magnifico40/ROS_robot/pulpit.png

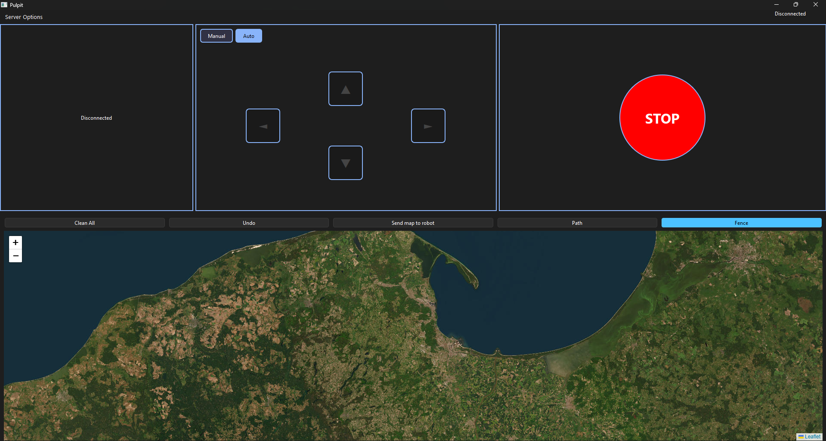
pulpit.png
