magnifico40/ROS_robot/foc controller/pcb/BOM_FOC_controller_PCB1_2026-02-05.xlsx

No. | Quantity | Comment | Designator | Footprint | Value | Manufacturer Part | Manufacturer | Supplier Part | Supplier
1 | 3 | 330uF | C1,C16,C17 | CAP-TH_BD13.0-P5.00-D1.2-FD | 330uF | 63V330uF CD288 | HRK(鸿瑞凯电子) | C2960417 | LCSC
2 | 3 | 4.7nF | C22,C23,C24 | C0805 | 4.7nF | CC0805KRX7R9BB472 | YAGEO(国巨) | C107153 | LCSC
3 | 6 | 100nF | C25,C26,C27,C31,C32,C33 | C0805 | 100nF | CC0805KRX7R9BB104 | YAGEO(国巨) | C49678 | LCSC
4 | 2 | 1uF | C34,C35 | C0805 | 1uF | CL21B105KBFNNNE | SAMSUNG(三星) | C28323 | LCSC
5 | 3 | 4.7uF | C36,C37,C38 | C1206 | 4.7uF | CL31B475KBHNNNE | SAMSUNG(三星) | C51205 | LCSC
6 | 1 | XT60U-M | CN1 | CONN-TH_XT60U-M |  | XT60U-M | AMASS(艾迈斯) | C129184 | LCSC
7 | 1 | XY-B5B-XH | CN2 | CONN-TH_5P-P2.50_XY-B5B-XH |  | XY-B5B-XH | XYECONN(辛译) | C51940193 | LCSC
8 | 3 | UF4007 | D1,D2,D3 | DO-41_BD2.4-L4.7-P8.70-D0.9-RD |  | UF4007 | MDD(辰达半导体) | C960666 | LCSC
9 | 1 | ESP32-S3-Zero | Filippo | esp32-s3-zero
10 | 1 | LM2596 | Filippo1 | stepDownLM2596
11 | 2 | 2.54-1*4P母 | H2,H3 | HDR-TH_4P-P2.54-V-F |  | 2.54-1*4P母 | BOOMELE(博穆精密) | C2718488 | LCSC
12 | 1 | PM2.54-1X8PM-H85 | P1 | HDR-TH_8P-P2.54-V-F |  | PM2.54-1X8PM-H85 | JXTCONN(聚兴泰) | C42431840 | LCSC
13 | 1 | WJ500V-5.08-03P-14-00A | P2 | CONN-TH_3P-P5.00_WJ500V-5.08-3P |  | WJ500V-5.08-03P-14-00A | KANGNEX(康奈克斯电气) | C72334 | LCSC
14 | 6 | STP110N8F6 | Q1,Q2,Q3,Q4,Q5,Q6 | TO-220-3_L10.0-W4.5-P2.54-L |  | STP110N8F6 | ST(意法半导体) | C81146 | LCSC
15 | 3 | 2mΩ | R1,R11,R18 | R2512 | 2mΩ | JER2512F3R002 | JIERR(捷而瑞) | C46634447 | LCSC
16 | 6 | 20Ω | R2,R3,R12,R13,R19,R20 | RES-TH_BD3.5-L9.0-P13.00-D0.5 | 20Ω | MO1/2W-20Ω±5%-XT52 | VO(翔胜) | C601756 | LCSC
17 | 12 | 10kΩ | R4,R5,R6,R7,R14,R15,R16,R17,R21,R22,R23,R24 | RES-TH_BD2.7-L6.2-P10.20-D0.4 | 10kΩ | MF1/4W-10K±1%-ST52 | VO(翔胜) | C2903232 | LCSC
18 | 3 | 1kΩ | R8,R25,R26 | RES-TH_BD2.7-L6.2-P10.20-D0.4 | 1kΩ | MF1/4W-1K±1%-ST52 | VO(翔胜) | C2903245 | LCSC
19 | 1 | 47kΩ | R9 | RES-TH_BD2.2-L6.5-P10.50-D0.6 | 47kΩ | MF1/4W-47KΩ±1% T | CCO(千志电子) | C119362 | LCSC
20 | 1 | 3.3kΩ | R10 | RES-TH_BD2.3-L6.5-P10.50-D0.5 | 3.3kΩ | MF1/4W-3.3KΩ±1% T | CCO(千志电子) | C119335 | LCSC
21 | 3 | EG2104S | U1,U3,U5 | SOIC-8_L5.0-W4.0-P1.27-LS6.0-BL |  | EG2104S | EG(屹晶微) | C480652 | LCSC
22 | 3 | INA240A1PWR | U2,U4,U6 | TSSOP-8_L4.4-W3.0-P0.65-LS6.4-BL |  | INA240A1PWR | TI(德州仪器) | C93965 | LCSC
23 | 1 | L7805 | U7 | TO-220-3_L10.0-W4.5-P2.54-L |  | L7805 | OSEN(欧芯) | C22378639 | LCSC
