magnifico40/ROS_robot/foc controller/pcb/SCH_FOC_controller_2026-04-19.pdf

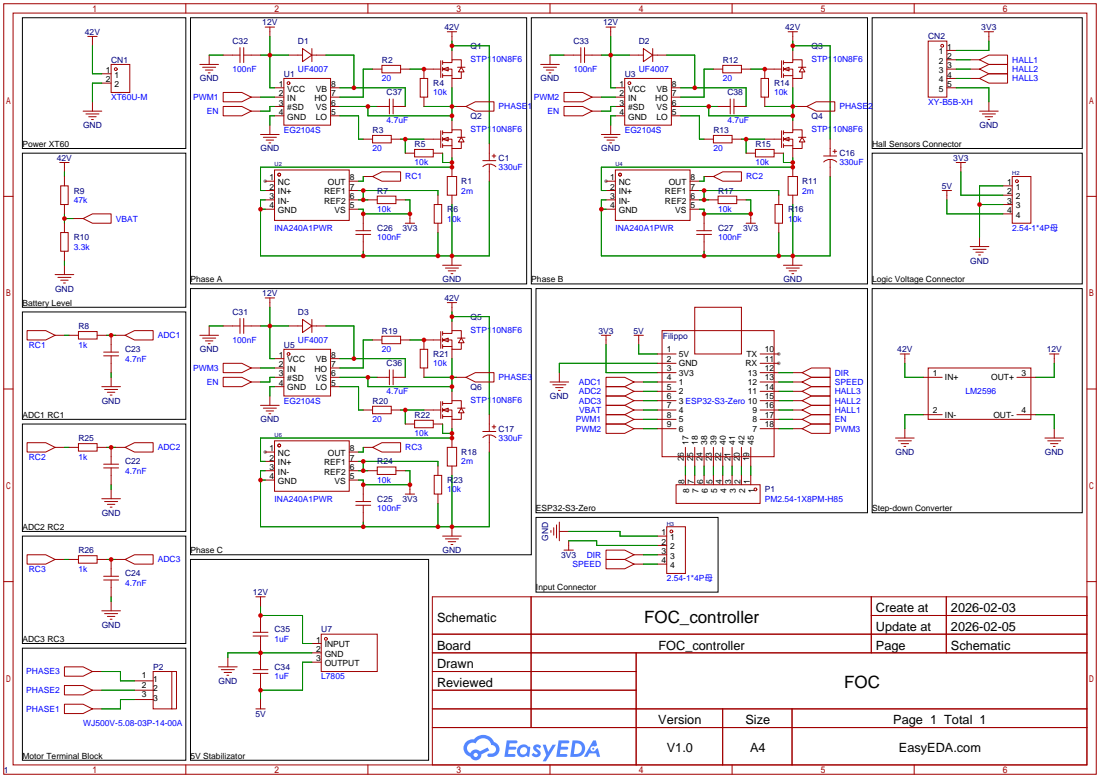
[picture p3: page 1]

Schematic | FOC_controller | Create at | 2026-02-03

Update at | 2026-02-05

Board | FOC_controller | Page | Schematic
Drawn | | FOC
Reviewed

Version | Size | Page 1 Total 1
V1.0 | A4 | EasyEDA.com
