magnifico40/ROS_robot/foc controller/pcb/PCB_PCB1_2026-04-19.pdf

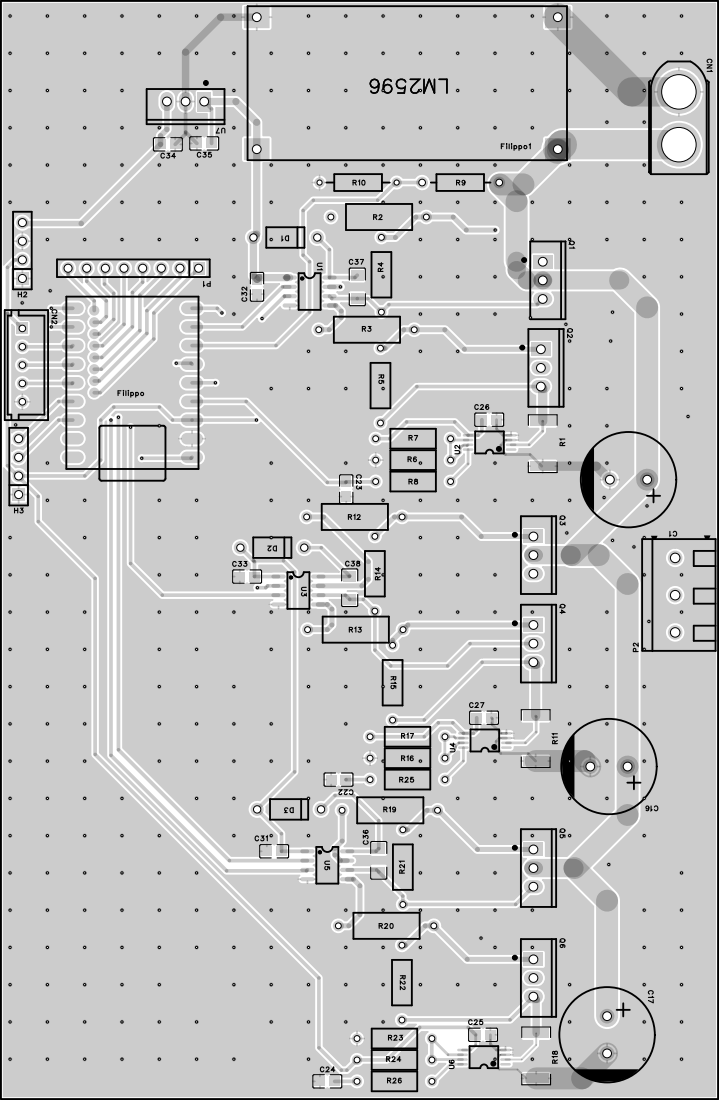
[picture p4: page 1]

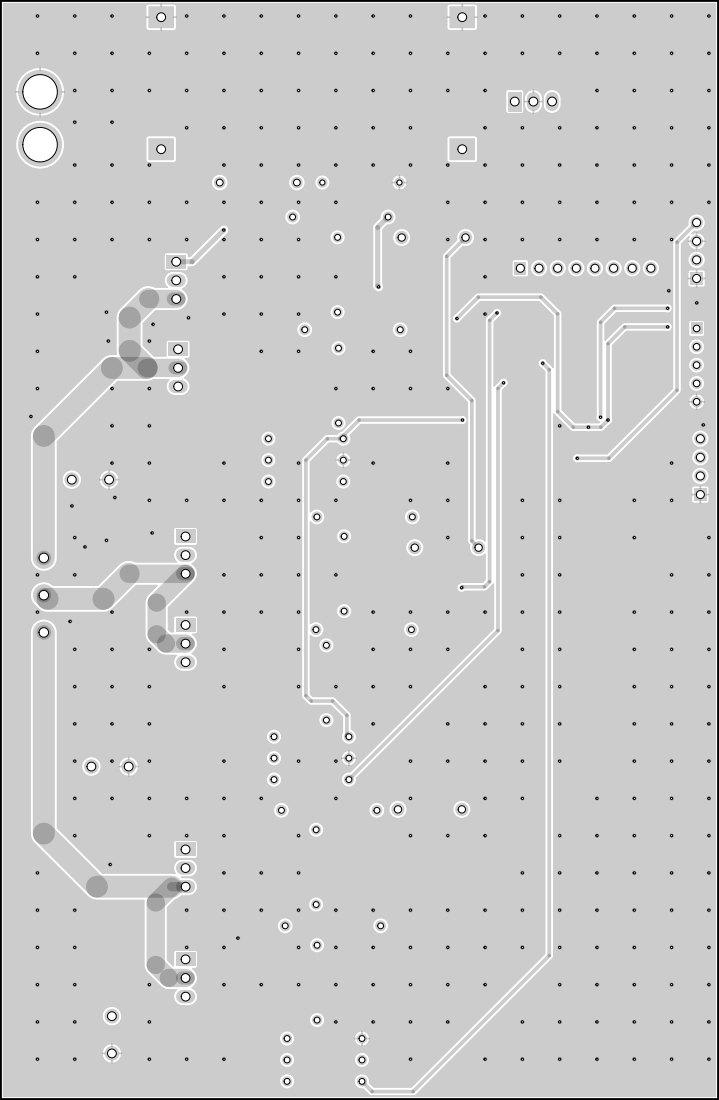
[picture p5: page 2]

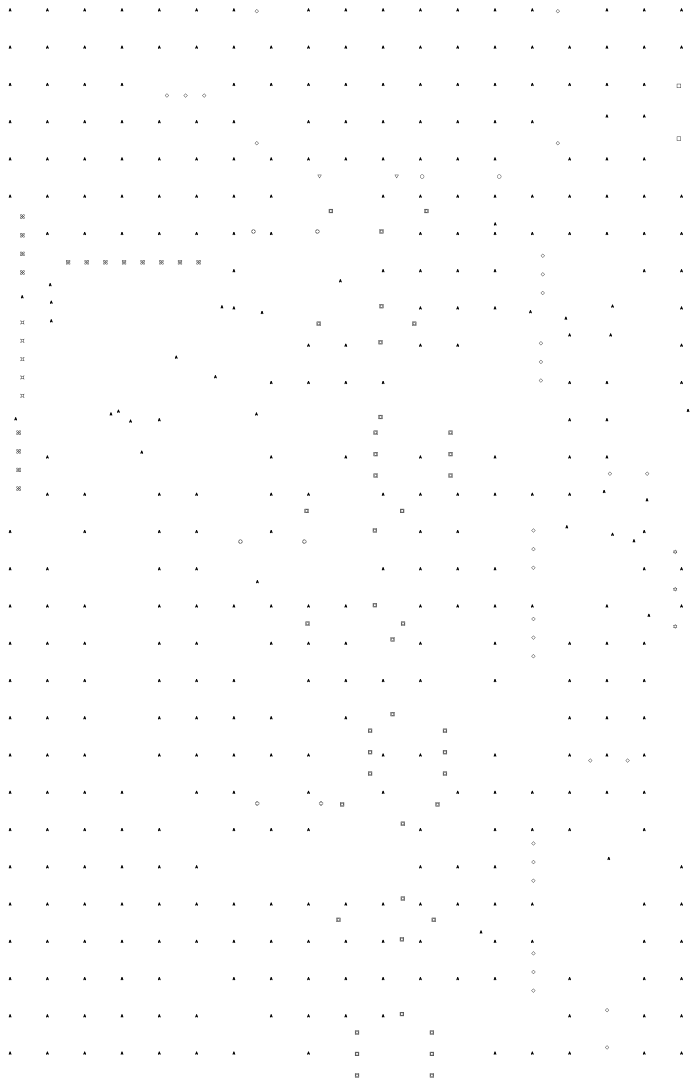
[picture p6: page 3]
