magnifico40/ROS_robot/sim_files/src/obstacle_avoidance2/config/dual_ekf.yaml

ekf_local:
  ros__parameters:
    frequency: 30.0        
    two_d_mode: true       
    publish_tf: true       
    use_sim_time: true
    
    odom_frame: odom
    base_link_frame: base_footprint
    world_frame: odom

    odom0: /odom
    odom0_config: [false,  false,  false,
                   false,  false,  false,
                   true,   false,  false,
                   false,  false,  true,
                   false,  false,  false]
    
    imu0: /imu
    imu0_config: [false,  false,  false,
                  false,  false,  false,
                  false,  false,  false,
                  false,  false,  true,
                  false,  false,  false]

ekf_global:
  ros__parameters:
    frequency: 30.0        
    two_d_mode: true       
    use_sim_time: true
    publish_tf: true        
    transform_timeout: 0.2
    map_frame: map
    odom_frame: odom
    base_link_frame: base_footprint
    world_frame: map
    
    predict_to_current_time: true

    odom0: /odom           
    odom0_config: [false,  false,  false,
                   false,  false,  false,
                   true,   false,  false,
                   false,  false,  true,
                   false,  false,  false]
    
    imu0: /imu
    imu0_config: [false,  false,  false,
                  false,  false,  true,
                  false,  false,  false,
                  false,  false,  true,
                  false,  false,  false]
                  
    odom1: /odometry/gps
    odom1_config: [true,   true,   false,
                   false,  false,  false,
                   false,  false,  false,
                   false,  false,  false,
                   false,  false,  false]

navsat_transform:
  ros__parameters:
    frequency: 30.0
    use_sim_time: true
    wait_for_datum: true
    datum: [52.229700, 21.012200, 0.0]
    use_odometry_yaw: false
    base_link_frame: base_footprint
    broadcast_cartesian_transform: false 
    transform_timeout: 2.0
    delay: 2.0
    magnetic_declination_radians: 0.12
    zero_altitude: true
    publish_filtered_gps: true
    yaw_offset: 0.0
    gps_covariance: [0.1, 0.0, 0.0, 0.0, 0.1, 0.0, 0.0, 0.0, 0.1,
                     0.0, 0.0, 0.0, 0.0, 0.0, 0.0, 0.0, 0.0, 0.0,
                     0.0, 0.0, 0.0, 0.0, 0.0, 0.0, 0.0, 0.0, 0.0,
                     0.0, 0.0, 0.0, 0.0, 0.0, 0.0, 0.0, 0.0, 0.0,
                     0.0, 0.0, 0.0, 0.0, 0.0, 0.0, 0.0, 0.0, 0.0,
                     0.0, 0.0, 0.0, 0.0, 0.0, 0.0, 0.0, 0.0, 0.0]
