magnifico40/ROS_robot/(commit log)

2026-04-19 added code for esp32s3 on foc controller pcb
2026-04-19 added foc controller pcb files
    [BOM_FOC_controller_PCB1_2026-02-05.xlsx]
2026-04-19 changed analogRead() to analogReadMilliVolts() for better results added battery voltage filtering to decrease number of errors due to current spikes
    [esp32_s3_foc.ino]
2026-04-20 added esp32 master code
2026-04-24 Sending IMU and gps data to SBC, receiving rtk fix data
    [esp32_Master.ino]
2026-04-24 added serial_nodeV2 including sending motor commands to esp32, receiving gps data and sending gps fix, receiving imu data
2026-04-24 Revert "added serial node"
    This reverts commit 695a791a9b2a6fa10e054fdc6ebc44e4d12c770e.
    [esp32_s3_foc.ino]
2026-04-24 separate directory for esp32 files
2026-04-26 added imu calibration on start
2026-05-30 disabled error during initFOC
    [esp32_s3_foc.ino]
2026-05-30 updated remote desktop
    smoother steering, mowing on/off, robot on map, general fixes
2026-06-04 Added obstacle_avoidance and new model
    [camera_extrinsic_calibration.yaml, camera_intrinsic_calibration.yaml, robot.xacro]
